joyontadebnath/frequency-stabilizer/docs/photo_6260512693823850052_y.jpg

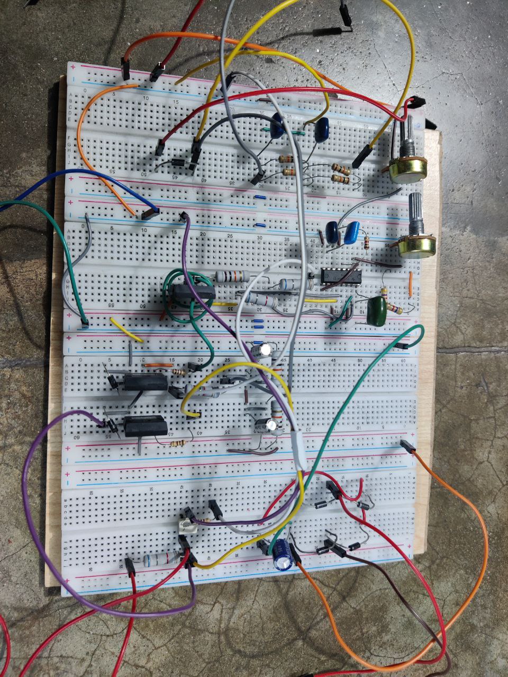
docs/photo_6260512693823850052_y.jpg
