joyontadebnath/frequency-stabilizer/(list of files, drawings)

Other design files:
scr/Freq_Stable.pdsprj
scr/Freq_Stable_Backup.pdsprj
